sabanekko3/sMDU_PCB/sMDU.pdf

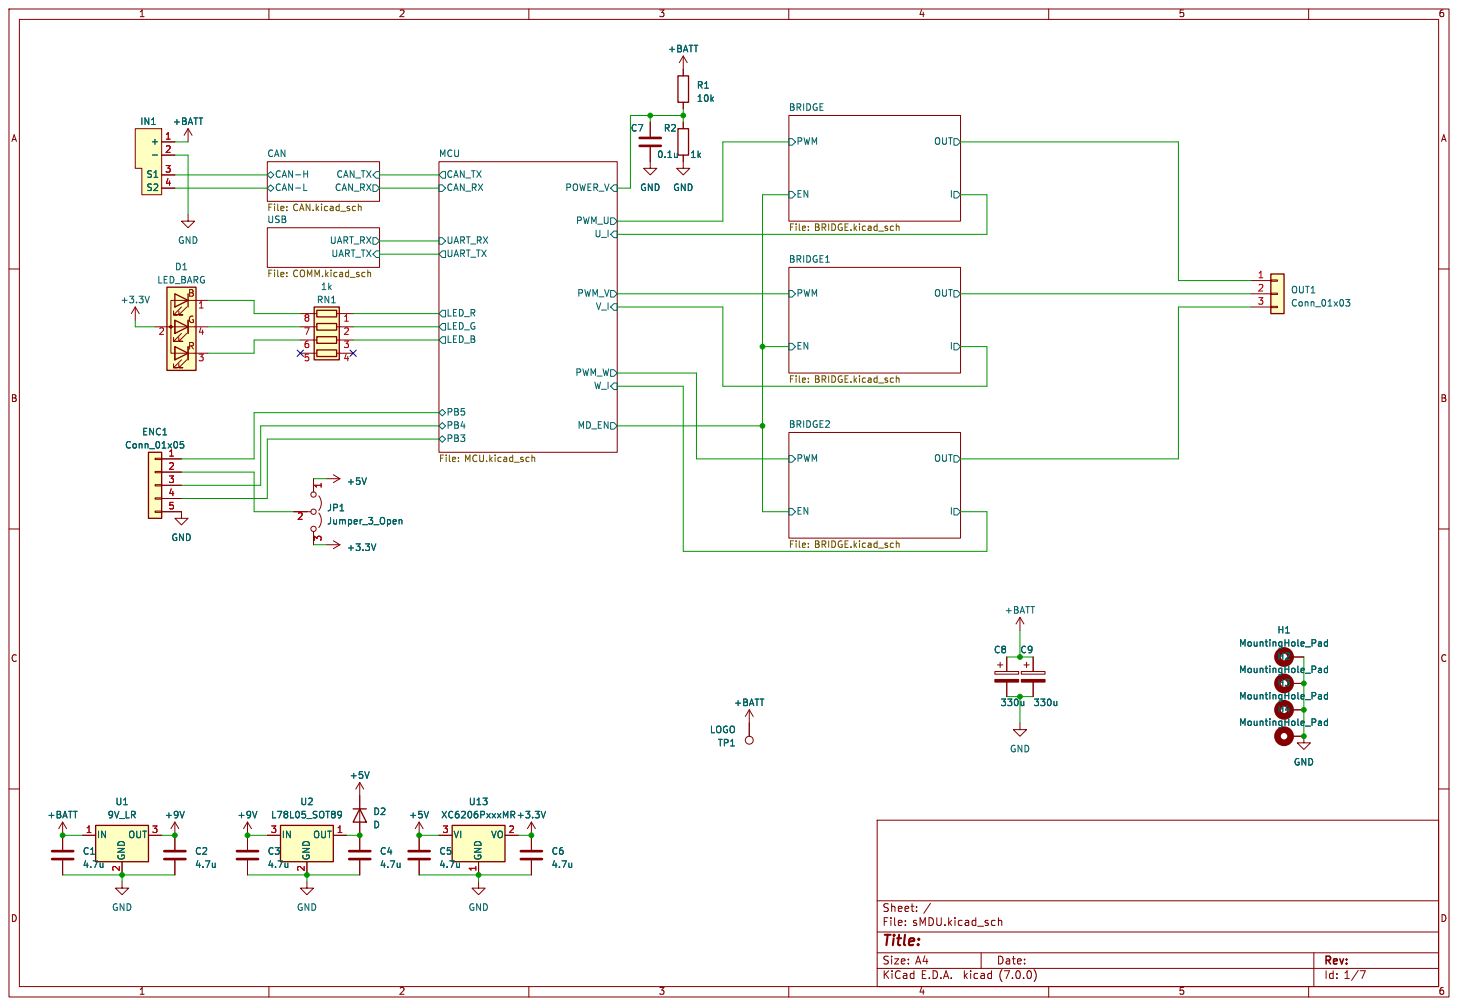
[picture p1: page 1]

Id: 1/7 Title: File: sMDU.kicad_sch Sheet: /

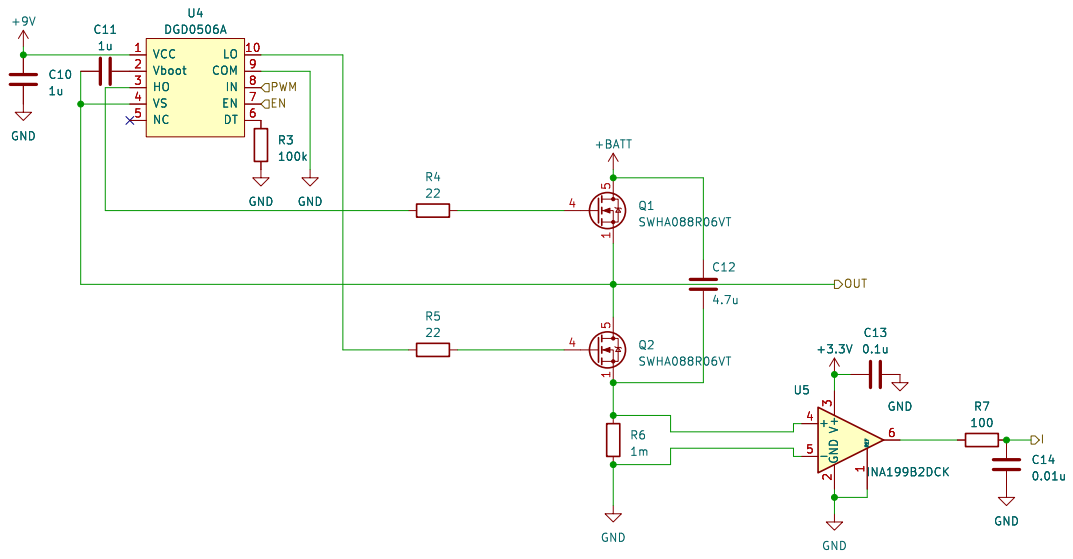
[picture p2: page 2]

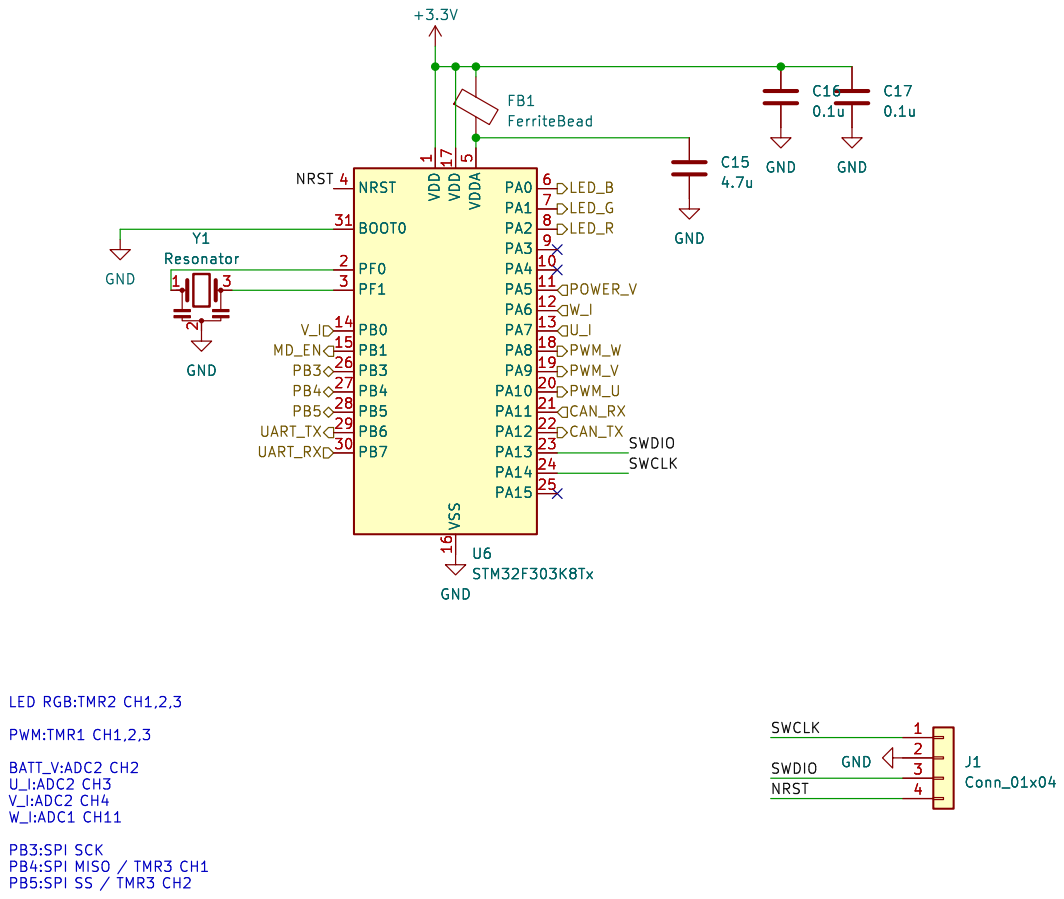
[picture p3: page 3]

1 PA4 10 PA5 11 PA6 12 PA7 13 PB0 14 PB1 15 VSS 16 VDD 17 PA8 18 PA9 19 PF0 2 PA10 20 PA11 21 PA12 22 PA13 23 PA14 24 PA15 25 PB3 26 PB4 27 PB5 28 PB6 29 PF1 3 PB7 30 BOOT0 31 NRST 4 VDDA

LED RGB:TMR2 CH1,2,3 PWM:TMR1 CH1,2,3 BATT_V:ADC2 CH2 U_I:ADC2 CH3 V_I:ADC2 CH4 W_I:ADC1 CH11 PB3:SPI SCK

Id: 3/7 Title: File: MCU.kicad_sch Sheet: /MCU/

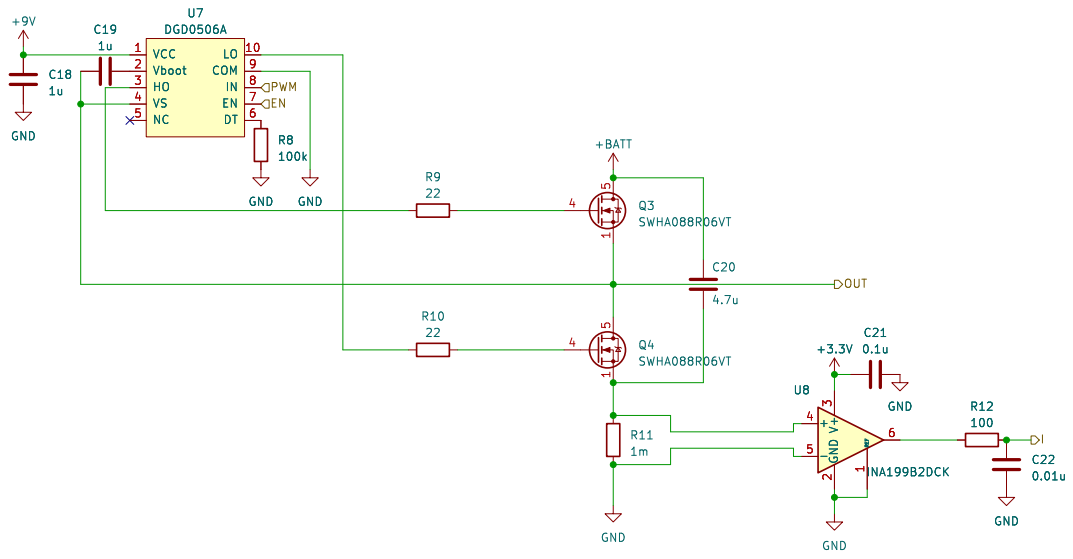
[picture p4: page 4]

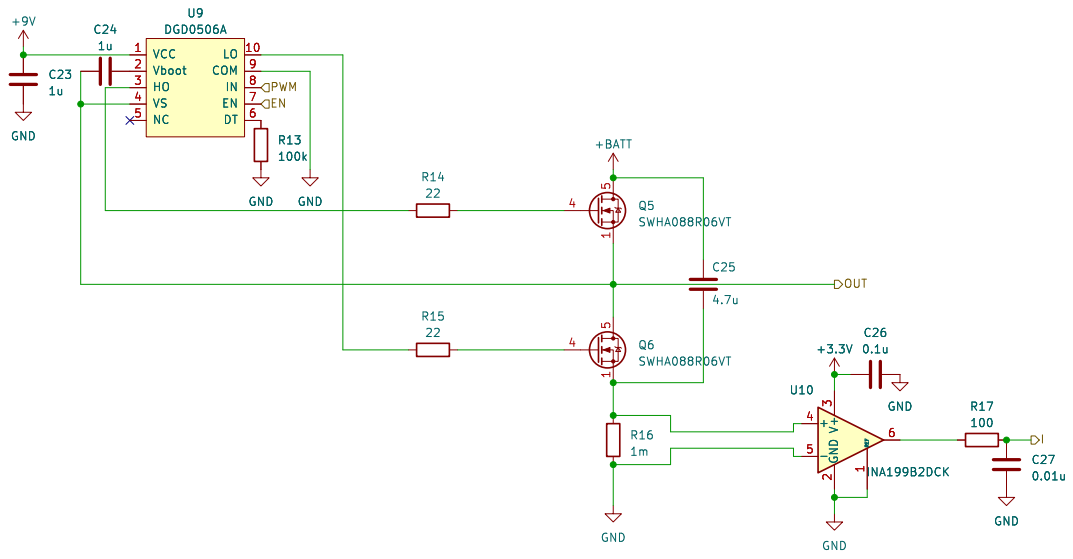
[picture p5: page 5]

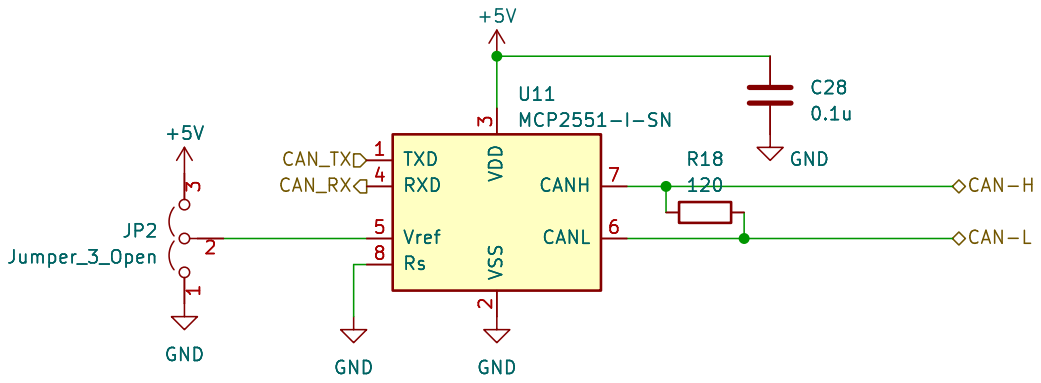
[picture p6: page 6]

3 RXD 4 Vref 5 CANL 6 CANH 7 Rs 8 U11 MCP2551-I-SN

3 RXD 4 Vref 5 CANL 6 CANH 7 Rs 8

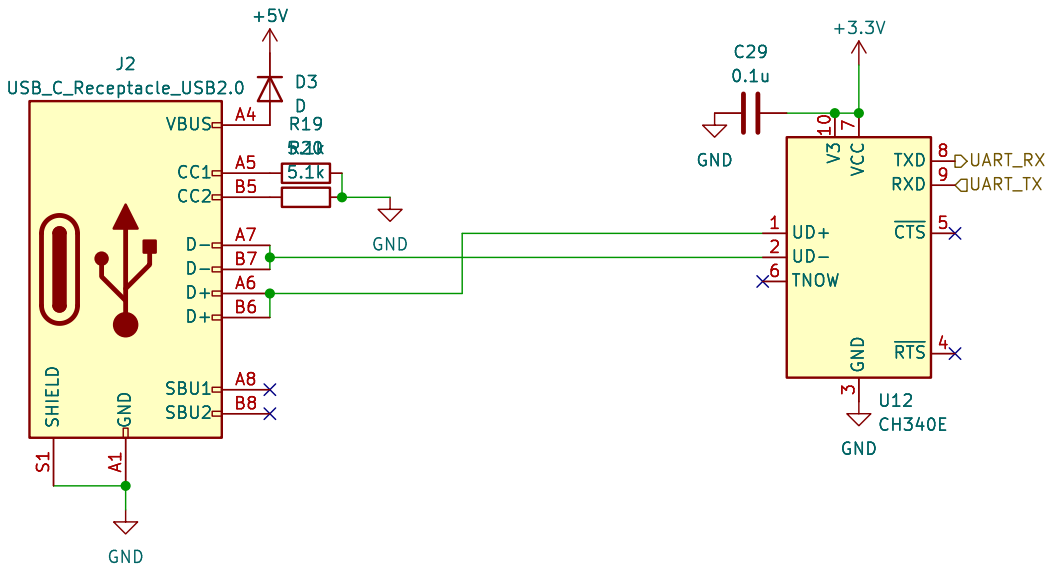
[picture p7: page 7]

Id: 8/7 Title: File: COMM.kicad_sch Sheet: /USB/
