sabanekko3/sMDU_PCB/sMDU.kicad_pcb

## KiCad design sMDU.kicad_pcb (2023-06-22)

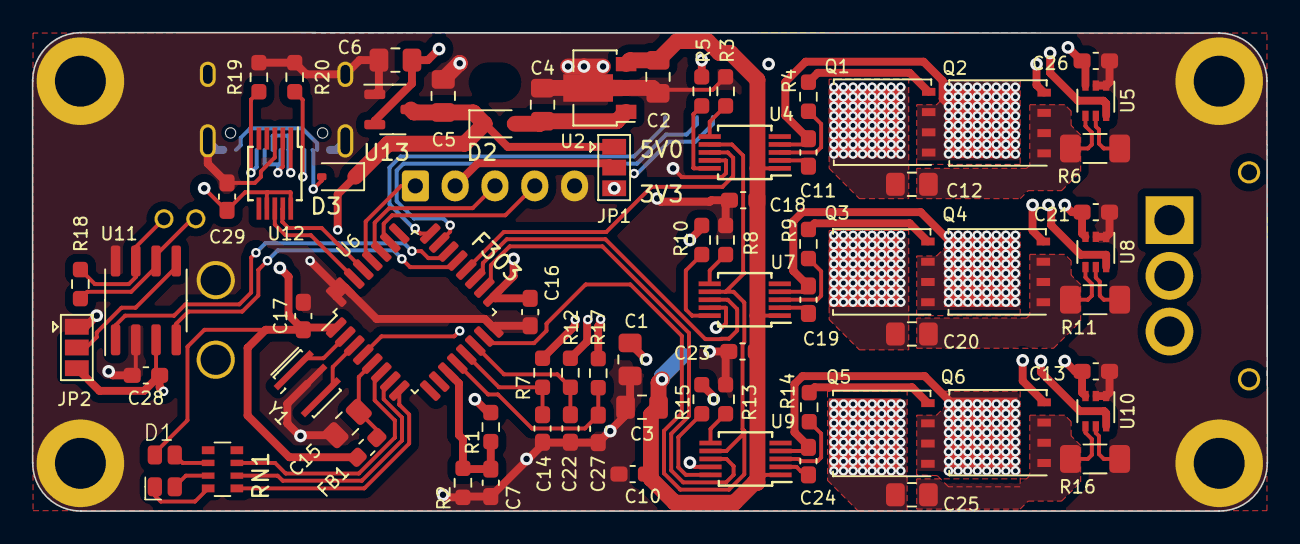
[picture p8: board sMDU.kicad_pcb from above]

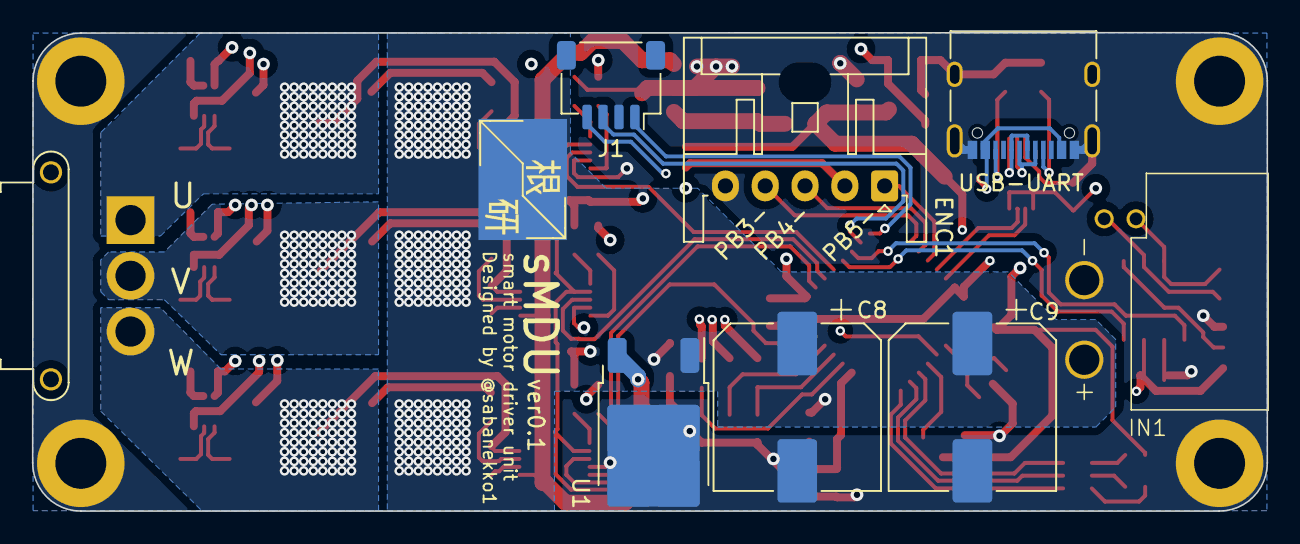
[picture p9: board sMDU.kicad_pcb from below]

Board: 4 copper layers, 77.6 x 30.1 mm, 85 parts (9 on the bottom side), 69 nets.

Parts:
C1, C2, C3, C4, C5, C6, C12, C15, C20, C25: 4.7u; C_0805_2012Metric_Pad1.18x1.45mm_HandSolder
C7, C13, C16, C17, C21, C26, C28, C29: 0.1u; C_0603_1608Metric_Pad1.08x0.95mm_HandSolder
C8, C9: 330u; CP_Elec_10x10
C10, C11, C18, C19, C23, C24: 1u; C_0603_1608Metric_Pad1.08x0.95mm_HandSolder
C14, C22, C27: 0.01u; C_0603_1608Metric_Pad1.08x0.95mm_HandSolder
D1: LED_BARG; SMD,1.8x2mm
D2, D3: D; D_SOD-323
ENC1: Conn_01x05; JST_XA_S05B-XASK-1_1x05_P2.50mm_Horizontal
FB1: FerriteBead; L_0603_1608Metric_Pad1.05x0.95mm_HandSolder
H1, H2, H3, H4: MountingHole_Pad; MountingHole_3.2mm_M3_ISO14580_Pad
IN1: XT30PW22
J1: Conn_01x04; JST_SH_SM04B-SRSS-TB_1x04-1MP_P1.00mm_Horizontal
J2: USB_C_Receptacle_USB2.0; USB_C_Receptacle_XKB_U262-16XN-4BVC11
JP1, JP2: Jumper_3_Open; SolderJumper-3_P1.3mm_Open_Pad1.0x1.5mm
OUT1: Conn_01x03; AMASS_MR30PW-FB_1x03_P3.50mm_Horizontal
Q1, Q2, Q3, Q4, Q5, Q6: BSC050N04LS; TDSON-8-1
R1: 10k; R_0603_1608Metric_Pad0.98x0.95mm_HandSolder
R2: 1k; R_0603_1608Metric_Pad0.98x0.95mm_HandSolder
R3, R8, R13: 100k; R_0603_1608Metric_Pad0.98x0.95mm_HandSolder
R4, R5, R9, R10, R14, R15: 22; R_0603_1608Metric_Pad0.98x0.95mm_HandSolder
R6, R11, R16: 1m; R_1206_3216Metric_Pad1.30x1.75mm_HandSolder
R7, R12, R17: 100; R_0603_1608Metric_Pad0.98x0.95mm_HandSolder
R18: 120; R_0603_1608Metric_Pad0.98x0.95mm_HandSolder
R19, R20: 5.1k; R_0603_1608Metric_Pad0.98x0.95mm_HandSolder
RN1: 1k; R_Array_Convex_4x0603
TP1: LOGO; sabanegi
U1: 9V_LR; TO-252-2
U2: L78L05_SOT89; SOT-89-3
U4, U7, U9: DGD0506A; MSOP-10_3x3mm_P0.5mm
U5, U8, U10: INA199xxDCK; SOT-363_SC-70-6
U6: STM32F303K8Tx; LQFP-32_7x7mm_P0.8mm
U11: MCP2551-I-SN; SOIC-8_3.9x4.9mm_P1.27mm
U12: CH340E; MSOP-10_3x3mm_P0.5mm
U13: XC6206PxxxMR; SOT-23-3
Y1: Resonator; Resonator_SMD_Murata_CSTxExxV-3Pin_3.0x1.1mm_HandSoldering

Connections:
+3.3V: C6.1, C13.1, C16.1, C17.1, C21.1, C26.1, C29.2, D1.2 (A), FB1.1, JP1.3 (B), U5.3 (V+), U6.1 (VDD), U6.17 (VDD), U8.3 (V+), U10.3 (V+), U12.7 (VCC), U12.10 (V3), U13.2 (VO)
+5V: C5.1, C28.1, D2.1 (K), D3.1 (K), JP1.1 (A), JP2.3 (B), U11.3 (VDD), U13.3 (VI)
+9V: C2.1, C3.1, C10.2, C18.2, C23.2, U1.3 (OUT), U2.3 (IN), U4.1 (VCC), U7.1 (VCC), U9.1 (VCC)
+BATT: C1.1, C8.1, C9.1, C12.1, C20.1, C25.1, IN1.1 (+), Q1.5 (D), Q3.5 (D), Q5.5 (D), R1.1, TP1.1, U1.1 (IN)
/BRIDGE1/I: C22.1, R12.2, U6.14 (PB0)
/BRIDGE1/OUT: C19.1, OUT1.2, Q3.1 (S), Q3.2 (S), Q3.3 (S), Q4.5 (D), U7.4 (VS)
/BRIDGE1/PWM: U6.19 (PA9), U7.8 (IN)
/BRIDGE2/I: C27.1, R17.2, U6.12 (PA6)
/BRIDGE2/OUT: C24.1, OUT1.3, Q5.1 (S), Q5.2 (S), Q5.3 (S), Q6.5 (D), U9.4 (VS)
/BRIDGE2/PWM: U6.18 (PA8), U9.8 (IN)
/BRIDGE/EN: U4.7 (EN), U6.15 (PB1), U7.7 (EN), U9.7 (EN)
/BRIDGE/I: C14.1, R7.2, U6.13 (PA7)
/BRIDGE/OUT: C11.1, OUT1.1, Q1.1 (S), Q1.2 (S), Q1.3 (S), Q2.5 (D), U4.4 (VS)
/BRIDGE/PWM: U4.8 (IN), U6.20 (PA10)
/CAN/CAN-H: IN1.3 (S1), R18.1, U11.7 (CANH)
/CAN/CAN-L: IN1.4 (S2), R18.2, U11.6 (CANL)
/CAN/CAN_RX: U6.21 (PA11), U11.4 (RXD)
/CAN/CAN_TX: U6.22 (PA12), U11.1 (TXD)
/MCU/LED_B: RN1.3 (R3.1), U6.6 (PA0)
/MCU/LED_G: RN1.2 (R2.1), U6.7 (PA1)
/MCU/LED_R: RN1.1 (R1.1), U6.8 (PA2)
/MCU/NRST: J1.4, U6.4 (NRST)
/MCU/PB3: ENC1.4, U6.26 (PB3)
/MCU/PB4: ENC1.3, U6.27 (PB4)
/MCU/PB5: ENC1.1, U6.28 (PB5)
/MCU/POWER_V: C7.1, R1.2, R2.1, U6.11 (PA5)
/MCU/SWCLK: J1.1, U6.24 (PA14)
/MCU/SWDIO: J1.3, U6.23 (PA13)
/MCU/UART_RX: U6.30 (PB7), U12.8 (TXD)
/MCU/UART_TX: U6.29 (PB6), U12.9 (RXD)
GND: C1.2, C2.2, C3.2, C4.2, C5.2, C6.2, C7.2, C8.2, C9.2, C10.1, C13.2, C14.2, C15.2, C16.2, C17.2, C18.1, C21.2, C22.2, C23.1, C26.2, C27.2, C28.2, C29.1, ENC1.5, H1.1, H2.1, H3.1, H4.1, IN1.2 (-), J1.2, J2.A1 (GND), J2.A12 (GND), J2.B1 (GND), J2.B12 (GND), J2.S1 (SHIELD), JP2.1 (A), R2.2, R3.2, R6.2, R8.2, R11.2, R13.2, R16.2, R19.2, R20.2, U1.2 (GND), U2.2 (GND), U4.9 (COM), U5.1 (REF), U5.2 (GND), U5.5 (-), U6.16 (VSS), U6.31 (BOOT0), U6.32 (VSS), U7.9 (COM), U8.1 (REF), U8.2 (GND), U8.5 (-), U9.9 (COM), U10.1 (REF), U10.2 (GND), U10.5 (-), U11.2 (VSS), U11.8 (Rs), U12.3 (GND), U13.1 (GND), Y1.2
unnamed: D1.1 (BK), RN1.8 (R1.2)
unnamed: D1.4 (GK), RN1.7 (R2.2)
unnamed: D1.3 (RK), RN1.6 (R3.2)
unnamed: C4.1, D2.2 (A), U2.1 (OUT)
unnamed: D3.2 (A), J2.A4 (VBUS), J2.A9 (VBUS), J2.B4 (VBUS), J2.B9 (VBUS)
unnamed: ENC1.2, JP1.2 (C)
unnamed: J2.A5 (CC1), R19.1
unnamed: J2.B5 (CC2), R20.1
unnamed: JP2.2 (C), U11.5 (Vref)
unnamed: Q1.4 (G), R4.2
unnamed: Q2.4 (G), R5.2
unnamed: Q3.4 (G), R9.2
unnamed: Q4.4 (G), R10.2
unnamed: Q5.4 (G), R14.2
unnamed: Q6.4 (G), R15.2
unnamed: R7.1, U5.6
unnamed: R12.1, U8.6
unnamed: R17.1, U10.6
unnamed: R3.1, U4.6 (DT)
unnamed: R4.1, U4.3 (HO)
unnamed: R5.1, U4.10 (LO)
unnamed: C11.2, U4.2 (Vboot)
unnamed: C12.2, Q2.1 (S), Q2.2 (S), Q2.3 (S), R6.1, U5.4 (+)
unnamed: U6.2 (PF0), Y1.1
unnamed: U6.3 (PF1), Y1.3
unnamed: C15.1, FB1.2, U6.5 (VDDA)
unnamed: R8.1, U7.6 (DT)
unnamed: R9.1, U7.3 (HO)
unnamed: R10.1, U7.10 (LO)
unnamed: C19.2, U7.2 (Vboot)
unnamed: C20.2, Q4.1 (S), Q4.2 (S), Q4.3 (S), R11.1, U8.4 (+)
unnamed: R13.1, U9.6 (DT)
unnamed: R14.1, U9.3 (HO)
unnamed: R15.1, U9.10 (LO)
unnamed: C24.2, U9.2 (Vboot)
unnamed: C25.2, Q6.1 (S), Q6.2 (S), Q6.3 (S), R16.1, U10.4 (+)
unnamed: J2.A6 (D+), J2.B6 (D+), U12.1 (UD+)
unnamed: J2.A7 (D-), J2.B7 (D-), U12.2 (UD-)
